matejsedik/maturitny_projekt-strelba-terce/03_Navrh/navod_tabulka_pinov.docx

# Návod: ako dopĺňať tabuľku pinov

Tento návod patrí k súboru tabulka_pinov.xlsx (rovnaký priečinok, 03_Navrh). Tabuľka je zatiaľ len kostra. Dopĺňa sa po tom, ako sa nakúpia presné súčiastky.

# Na čo tabuľka slúži

Odpovedá na otázku, ktorý drôt ide do ktorého pinu na ESP32. Pin je kovová nožička na doske ESP32, jeho číslo sa volá GPIO. Na jeden pin sa pripája jedna vec (senzor, servo, spínač…). Podľa tabuľky zapája Sára a podľa tej istej tabuľky píše firmvér Matej.

# Čo je v tabuľke

Tabuľka má dva hárky (záložky dole):

- Terčová jednotka – piny pre ESP32 v terči (senzory zásahu, servá, motor krycieho plátu, koncové spínače, batéria, LED).
- Napájanie a pravidlá – ako sa čo napája a ktoré piny sa nesmú používať. Pred výberom pinu si ho prečítať.

# Čo znamenajú stĺpce

Stĺpec | Čo tam patrí
Funkcia | na čo to je (napr. „Snímanie zásahu – ľah, terč 1“). Zvyčajne už vyplnené.
Súčiastka | presný názov súčiastky tak, ako sa nakúpila (napr. typ z e-shopu alebo z obalu). Kostra obsahuje len pôvodne plánovaný typ, po nákupe sa prepíše skutočným.
Signál | názov vývodu na súčiastke (napr. OUT, PWM, IN1). Zistí sa zo schémy vývodov súčiastky (pinout).
GPIO | číslo pinu na ESP32, na ktorý sa signál pripojí. Toto je hlavná vec, ktorú treba doplniť.
Smer | či pin signál číta (vstup), alebo ho posiela (výstup).
Stav | Nevyplnené (GPIO ešte nie je zvolené), Návrh (zvolené, ale nezapojené), Overené (funguje na stole), Zapojené (zapojené na doske). Vyberá sa zo zoznamu.
Poznámka | upozornenia k zapojeniu (napr. vonkajší odpor, napájanie).

# Ako dopĺňať po nákupe – krok za krokom

1. Zistiť presný typ súčiastky z balenia alebo z objednávky a prepísať ho do stĺpca Súčiastka.
2. Nájsť schému vývodov (pinout) danej súčiastky v popise obchodu alebo v datasheete. Skontrolovať, aký signál súčiastka vyvádza a aké napätie potrebuje (3,3 V alebo 5 V).
3. Vybrať GPIO podľa pravidiel z hárku Napájanie a pravidlá: nepoužívať GPIO6–11, pre vstupy sa vyhnúť pinom 0, 2, 5, 12, 15, piny 34–39 sú len vstupy a pre spínače potrebujú vonkajší odpor 10 kΩ, batériu merať na pinoch 32–39.
4. Zapísať číslo do stĺpca GPIO a upraviť Smer a Poznámku, ak sa líšia od kostry.
5. Skontrolovať duplicity: v hornej časti hárka (riadok 3) musí byť „OK – žiadny pin sa neopakuje“. Ak tam je POZOR, jeden pin je použitý dvakrát a treba ho zmeniť.
6. Nastaviť Stav na Návrh. Po odskúšaní na stole na Overené a po zapojení na doske na Zapojené.
7. Prepísať rovnaké čísla do kódu: súbor piny.h v priečinku 04_Implementacia/src/firmver-terc musí obsahovať tie isté čísla ako tabuľka.
8. Oznámiť druhému (Sára Matejovi a naopak), že sa niečo zmenilo.

# Čo ak sa niečo zmení

Keď sa zmení súčiastka alebo zapojenie, upraví sa riadok v tabuľke a rovnaké číslo v súbore piny.h. Ak treba pridať ďalšiu súčiastku, použije sa prvý prázdny riadok na konci hárka (kontrola duplicít ho zahŕňa). Ak je riadkov málo, vloží sa nový riadok medzi existujúce a vzorec sa roztiahne.

# Príklad vyplneného riadka

Toto je len ukážka, nie skutočné údaje:

Stĺpec | Ukážka
Funkcia | Snímanie zásahu – ľah, terč 1
Súčiastka | Hallov senzor A3144 (typ z objednávky)
Signál | OUT
GPIO | (číslo pinu, ktoré sa vyberie)
Smer | vstup (INPUT_PULLUP)
Stav | Návrh → Overené → Zapojené

# Kto za čo zodpovedá

- Sára vlastní tabuľku: podľa nej zapája a dopĺňa ju pri zmene zapojenia.
- Matej podľa nej píše firmvér a udržiava súbor piny.h.
- Obaja si hlásia zmeny a zapisujú dôležité zmeny postupu do dokumentacia_postup_prac.docx (priečinok 06_Dokumentacia).
