matejsedik/maturitny_projekt-strelba-terce/03_Navrh/navrhy_zapojenia/navrh_zapojenia_00_prehlad.pdf

# Prehľad návrhov zapojenia

Z čoho sa skladá elektronika terčovej jednotky, ako sa spája s mobilom a v ktorom súbore je ktoré zapojenie nakreslené.

## NÁVRH ZAPOJENIA

Strana 1/1: prehľad

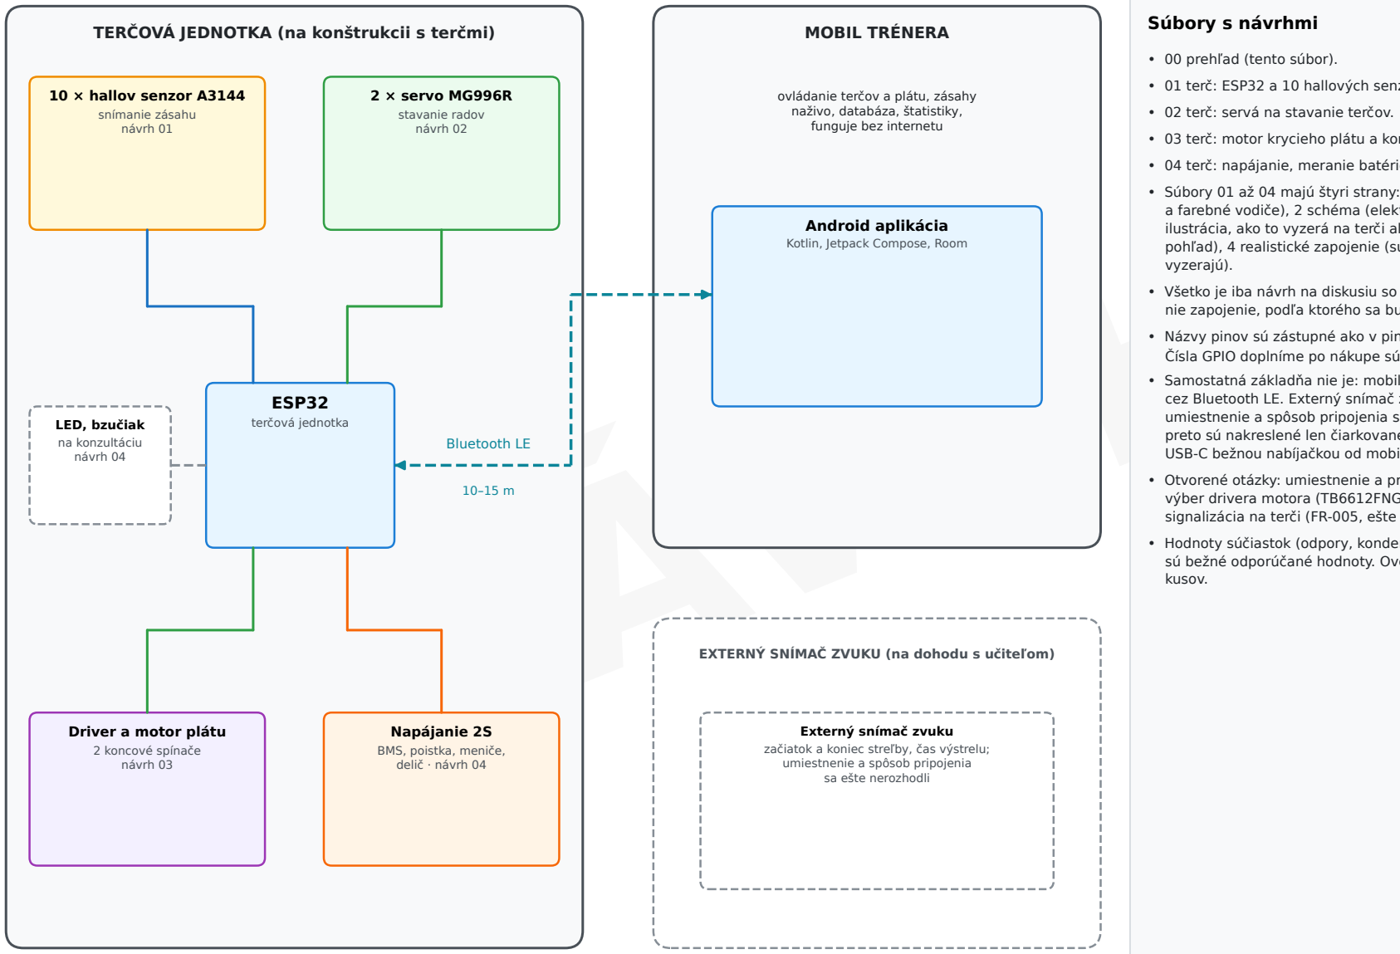
[picture p1: figure]
NÁVRH; Súbory s návrhmi; • 00 prehľad (tento súbor).; • 02 terč: servá na stavanie terčov.; vyzerajú).; kusov.; ESP32; terčová jednotka; 10 × hallov senzor A3144; snímanie zásahu návrh 01; 2 × servo MG996R stavanie radov návrh 02; Driver a motor plátu 2 koncové spínače návrh 03; Napájanie 2S BMS, poistka, meniče, delič · návrh 04; LED, bzučiak na konzultáciu návrh 04; MOBIL TRÉNERA; Android aplikácia Kotlin, Jetpack Compose, Room; ovládanie terčov a plátu, zásahy naživo, databáza, štatistiky, funguje bez internetu; Externý snímač zvuku; umiestnenie a spôsob pripojenia sa ešte nerozhodli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

- 01 terč: ESP32 a 10 hallových senzorov.
- 03 terč: motor krycieho plátu a koncové spínače.
- 04 terč: napájanie, meranie batérie, LED a bzučiak.
- Súbory 01 až 04 majú štyri strany: 1 blokový nákres (moduly a farebné vodiče), 2 schéma (elektrotechnické značky), 3 ilustrácia, ako to vyzerá na terči alebo v krabičke (3D pohľad), 4 realistické zapojenie (súčiastky tak, ako
- Všetko je iba návrh na diskusiu so Sárou a s Ing. Hollým, nie zapojenie, podľa ktorého sa bude stavať.
- Názvy pinov sú zástupné ako v piny.h a tabulka_pinov.xlsx. Čísla GPIO doplníme po nákupe súčiastok.
- Samostatná základňa nie je: mobil sa s terčom spája priamo cez Bluetooth LE. Externý snímač zvuku sa pridá, ale jeho umiestnenie a spôsob pripojenia sa ešte dohodnú s učiteľom, preto sú nakreslené len čiarkovane. Nabíjanie terča cez USB-C bežnou nabíjačkou od mobilu (modul 2S).
- Otvorené otázky: umiestnenie a pripojenie snímača zvuku, výber drivera motora (TB6612FNG alebo DRV8833), signalizácia na terči (FR-005, ešte sa konzultuje).
- Hodnoty súčiastok (odpory, kondenzátory, napätia meničov) sú bežné odporúčané hodnoty. Overiť v datasheetoch kúpených
Iba návrh na diskusiu, nie zapojenie, podľa ktorého sa bude stavať. Pred zapojením overiť s datasheetom konkrétnej súčiastky a s Ing. Hollým. | navrh_zapojenia_00_prehlad.pdf · návrh z 8. 11. 2026

### TERČOVÁ JEDNOTKA (na konštrukcii s terčmi)

EXTERNÝ SNÍMAČ ZVUKU (na dohodu s učiteľom)

začiatok a koniec streľby, čas výstrelu;
