matejsedik/maturitny_projekt-strelba-terce/03_Navrh/navrhy_zapojenia/navrh_zapojenia_01_terc_hallove_senzory.pdf

# Terčová jednotka: ESP32 a 10 hallových senzorov

## NÁVRH ZAPOJENIA

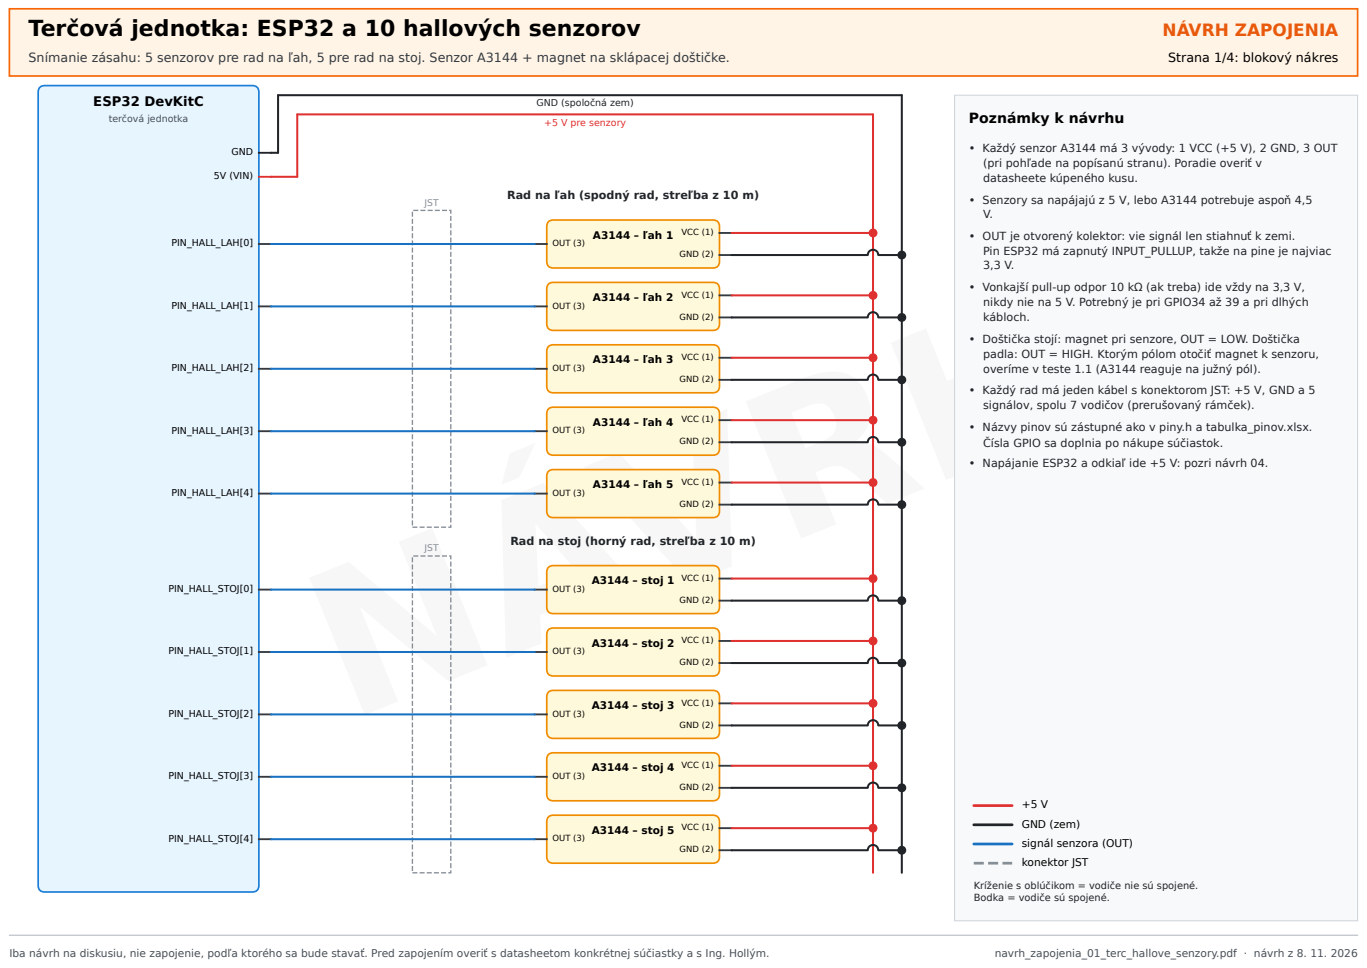
[picture p2: page 1]
NÁVRH; Poznámky k návrhu; Iba návrh na diskusiu, nie zapojenie, podľa ktorého sa bude stavať. Pred zapojením overiť s datasheetom konkrétnej súčiastky a s Ing. Hollým.; navrh_zapojenia_01_terc_hallove_senzory.pdf · návrh z 8. 11. 2026; ESP32 DevKitC; terčová jednotka; GND; 5V (VIN); PIN_HALL_LAH[0]; PIN_HALL_LAH[1]; PIN_HALL_LAH[2]; PIN_HALL_LAH[3]; PIN_HALL_LAH[4]; PIN_HALL_STOJ[0]; PIN_HALL_STOJ[1]; PIN_HALL_STOJ[2]; PIN_HALL_STOJ[3]; PIN_HALL_STOJ[4]; A3144 – ľah 1; OUT (3); VCC (1)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

Snímanie zásahu: 5 senzorov pre rad na ľah, 5 pre rad na stoj. Senzor A3144 + magnet na sklápacej doštičke.

Strana 1/4: blokový nákres

GND (spoločná zem)
+5 V pre senzory

• Každý senzor A3144 má 3 vývody: 1 VCC (+5 V), 2 GND, 3 OUT
(pri pohľade na popísanú stranu). Poradie overiť v
datasheete kúpeného kusu.
• Senzory sa napájajú z 5 V, lebo A3144 potrebuje aspoň 4,5
• OUT je otvorený kolektor: vie signál len stiahnuť k zemi.
Pin ESP32 má zapnutý INPUT_PULLUP, takže na pine je najviac
• Vonkajší pull-up odpor 10 kΩ (ak treba) ide vždy na 3,3 V,
nikdy nie na 5 V. Potrebný je pri GPIO34 až 39 a pri dlhých
kábloch.
• Doštička stojí: magnet pri senzore, OUT = LOW. Doštička
padla: OUT = HIGH. Ktorým pólom otočiť magnet k senzoru,
overíme v teste 1.1 (A3144 reaguje na južný pól).
• Každý rad má jeden kábel s konektorom JST: +5 V, GND a 5
signálov, spolu 7 vodičov (prerušovaný rámček).
• Názvy pinov sú zástupné ako v piny.h a tabulka_pinov.xlsx.
Čísla GPIO sa doplnia po nákupe súčiastok.
• Napájanie ESP32 a odkiaľ ide +5 V: pozri návrh 04.

Rad na ľah (spodný rad, streľba z 10 m)

Rad na stoj (horný rad, streľba z 10 m)

GND (zem)
signál senzora (OUT)
konektor JST

Kríženie s oblúčikom = vodiče nie sú spojené.
Bodka = vodiče sú spojené.

Strana 2/4: schéma

### Ako čítať schému

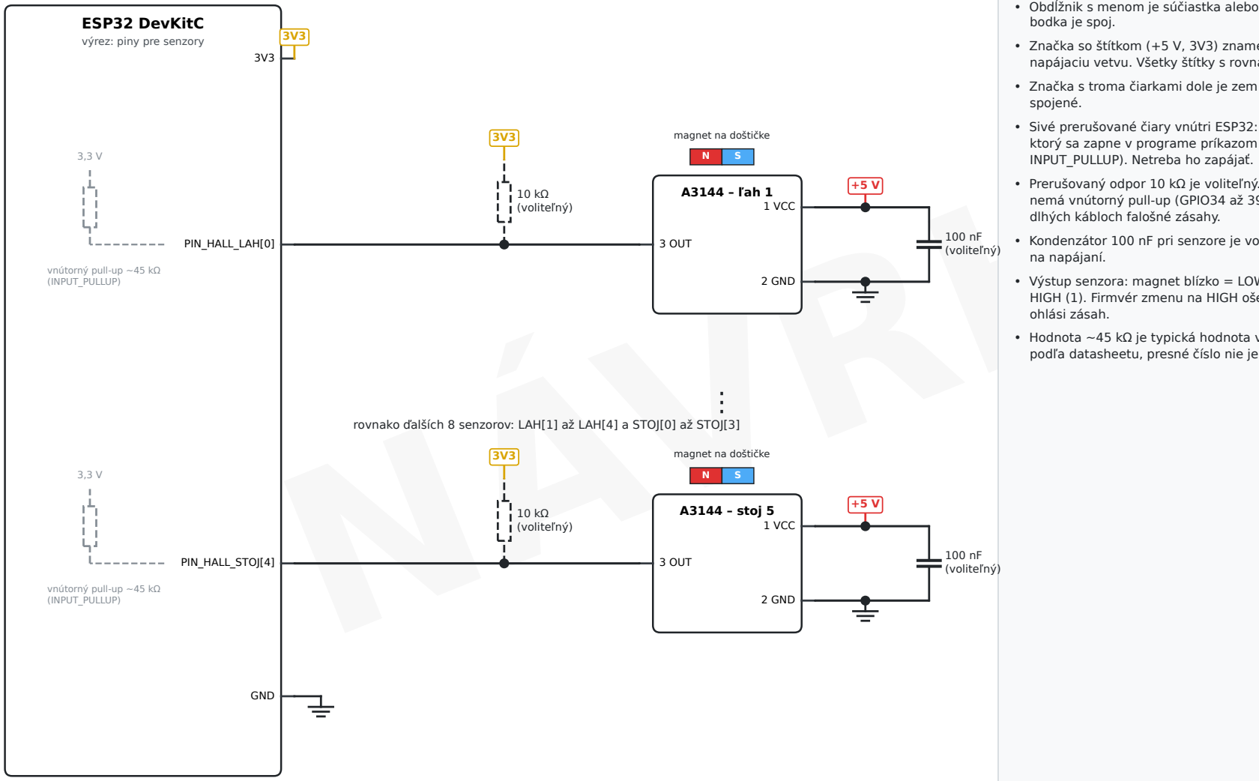
[picture p3: figure]
NÁVRH; bodka je spoj.; spojené.; INPUT_PULLUP). Netreba ho zapájať.; dlhých kábloch falošné zásahy.; na napájaní.; ohlási zásah.; ESP32 DevKitC; výrez: piny pre senzory; PIN_HALL_LAH[0]; PIN_HALL_STOJ[4]; GND; vnútorný pull-up ~45 kΩ (INPUT_PULLUP); A3144 – ľah 1; 3 OUT; 1 VCC; 2 GND; 10 kΩ (voliteľný); 100 nF (voliteľný); magnet na doštičke; A3144 – stoj 5

- Obdĺžnik s menom je súčiastka alebo modul, čiara je vodič,
- Značka so štítkom (+5 V, 3V3) znamená pripojenie na tú napájaciu vetvu. Všetky štítky s rovnakým menom sú spojené.
- Značka s troma čiarkami dole je zem (GND). Všetky zeme sú
- Sivé prerušované čiary vnútri ESP32: vnútorný pull-up,
ktorý sa zapne v programe príkazom pinMode(pin,
- Prerušovaný odpor 10 kΩ je voliteľný. Pridať ho, ak pin nemá vnútorný pull-up (GPIO34 až 39) alebo ak budú pri
- Kondenzátor 100 nF pri senzore je voliteľný, tlmí rušenie
- Výstup senzora: magnet blízko = LOW (0), magnet ďaleko = HIGH (1). Firmvér zmenu na HIGH ošetrí proti zákmitom a
- Hodnota ~45 kΩ je typická hodnota vnútorného pull-upu ESP32 podľa datasheetu, presné číslo nie je dôležité.

rovnako ďalších 8 senzorov: LAH[1] až LAH[4] a STOJ[0] až STOJ[3]

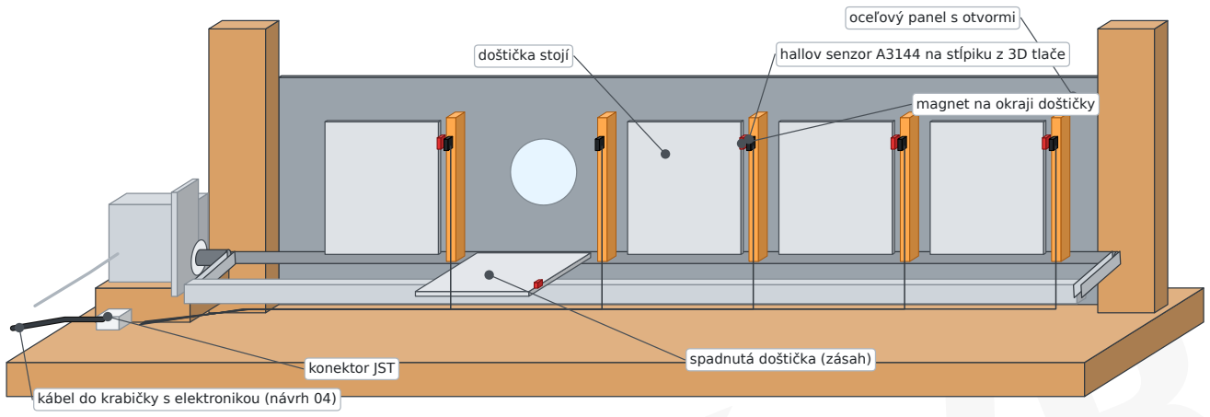
[picture p4: figure]
magnet na okraji doštičky; doštička stojí; spadnutá doštička (zásah) konektor JST; oceľový panel s otvormi

# NÁVRH

Strana 3/4: ako to vyzerá na terči (ilustrácia)

### Čo vidno na obrázku

- Je to zjednodušená ilustrácia, nie výkres. Rozmery a tvary sa budú upravovať pri 3D návrhu (Sára).
- Za každým otvorom stojí oceľová doštička na spoločnej osi. Zásah ju zhodí dozadu (k nám) na zdvíhaciu lištu.
- Na pravom okraji každej doštičky je nalepený malý magnet Ø 5 × 2 mm.
- Vedľa doštičky je stĺpik (3D tlač) a na ňom hallov senzor
vo výške magnetu. Senzor sa doštičky nedotýka, takže ho náraz strely nepoškodí.
- Stojaca doštička: magnet je pár milimetrov od senzora, výstup OUT je LOW. Spadnutá doštička: magnet sa vzdiali, OUT prejde na HIGH a ESP32 ohlási zásah.
- Od každého senzora idú 3 tenké vodiče dolu po stĺpiku a popri podstave ku konektoru JST. Jeden kábel na rad (7 vodičov).
- Rovnako vyzerá aj rad na ľah, len otvory majú Ø 15 mm a rad je nižšie.
- Vzdialenosť magnetu od senzora a ktorým pólom ho otočiť sa nájde v teste 1.1.

Terčový rad pri pohľade zozadu (strelec stojí za panelom)

Detail jednej doštičky

Doštička stojí: magnet je pri senzore → OUT = LOW (0) | Doštička spadla: magnet je ďaleko → OUT = HIGH (1)

hallov senzor A3144 na stĺpiku z 3D tlače

kábel do krabičky s elektronikou (návrh 04)

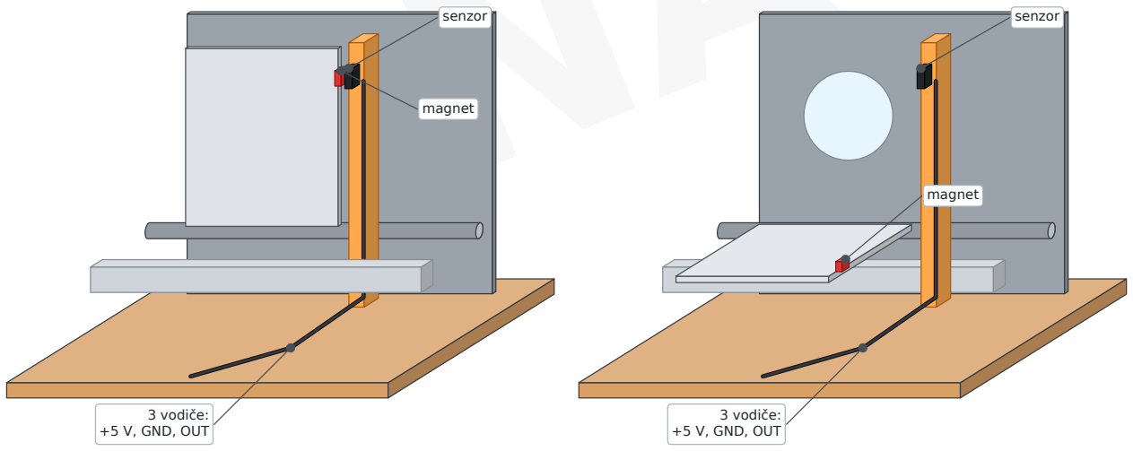
[picture p5: figure]
senzor; magnet; 3 vodiče: +5 V, GND, OUT

Strana 4/4: realistické zapojenie (ilustrácia)

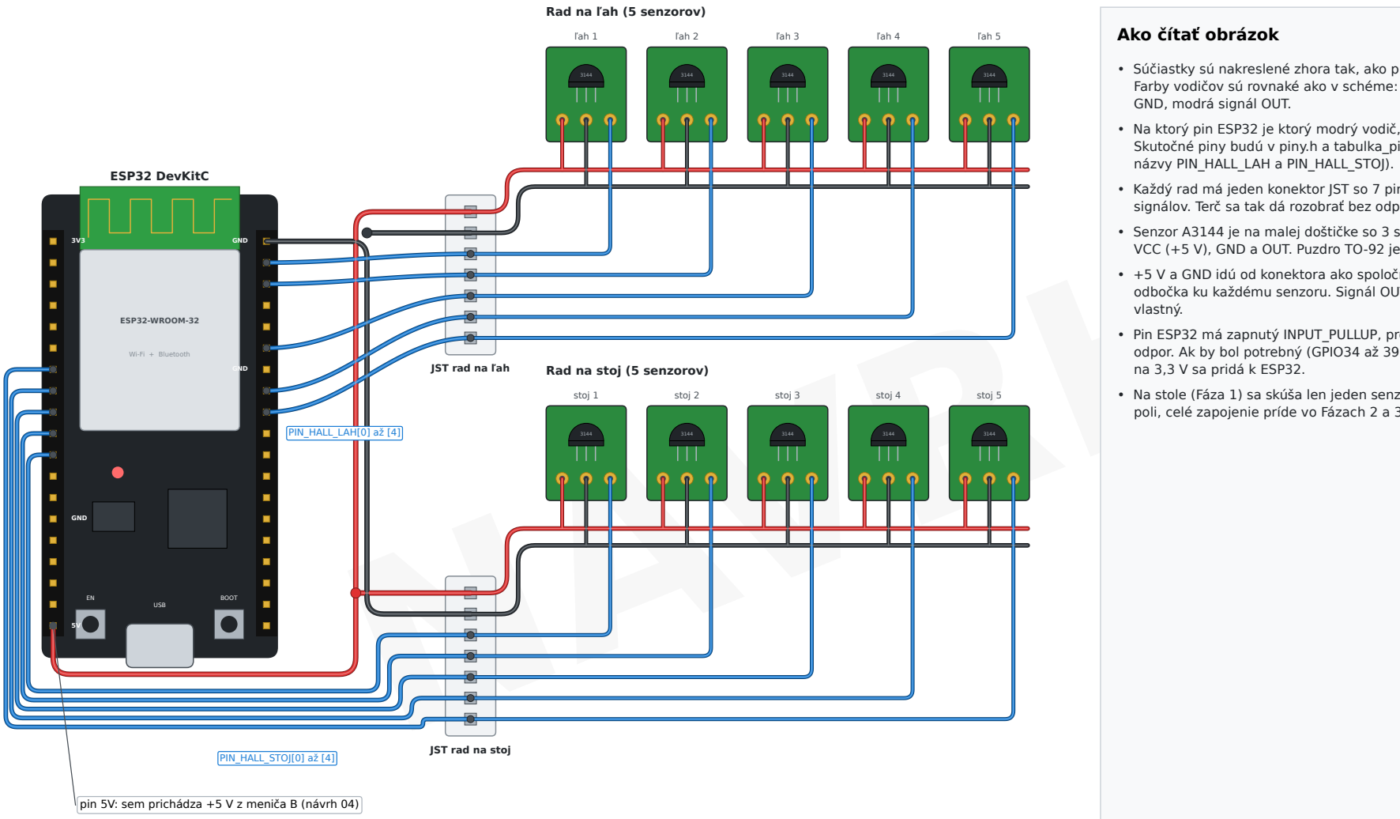
[picture p6: figure]
NÁVRH; Ako čítať obrázok; GND, modrá signál OUT.; názvy PIN_HALL_LAH a PIN_HALL_STOJ).; vlastný.; na 3,3 V sa pridá k ESP32.; ESP32-WROOM-32; Wi-Fi + Bluetooth; BOOT; USB; GND; ESP32 DevKitC; JST rad na ľah; JST rad na stoj; ľah 1; ľah 2; ľah 3; ľah 4; ľah 5; Rad na ľah (5 senzorov); stoj 1; stoj 2; stoj 3; stoj 4; stoj 5; Rad na stoj (5 senzorov); PIN_HALL_LAH[0] až [4]; PIN_HALL_STOJ[0] až [4]

- Súčiastky sú nakreslené zhora tak, ako približne vyzerajú. Farby vodičov sú rovnaké ako v schéme: červená +5 V, čierna
- Na ktorý pin ESP32 je ktorý modrý vodič, je len ilustrácia. Skutočné piny budú v piny.h a tabulka_pinov.xlsx (zástupné
- Každý rad má jeden konektor JST so 7 pinmi: +5 V, GND a 5 signálov. Terč sa tak dá rozobrať bez odpájkovania.
- Senzor A3144 je na malej doštičke so 3 spájkovacími bodmi: VCC (+5 V), GND a OUT. Puzdro TO-92 je otočené k magnetu.
- +5 V a GND idú od konektora ako spoločné vodiče a od nich odbočka ku každému senzoru. Signál OUT má každý senzor
- Pin ESP32 má zapnutý INPUT_PULLUP, preto na doštičke nie je odpor. Ak by bol potrebný (GPIO34 až 39, dlhé káble), 10 kΩ
- Na stole (Fáza 1) sa skúša len jeden senzor na nepájivom poli, celé zapojenie príde vo Fázach 2 a 3.

pin 5V: sem prichádza +5 V z meniča B (návrh 04)
