matejsedik/maturitny_projekt-strelba-terce/03_Navrh/navrhy_zapojenia/navrh_zapojenia_04_terc_napajanie_a_signalizacia.pdf

# Terčová jednotka: napájanie, meranie batérie a signalizácia

Batéria 2 × 18650 (2S) s ochranou, poistka, vypínač, dva meniče napätia, delič na meranie batérie, LED a bzučiak (na konzultáciu).

## NÁVRH ZAPOJENIA

Strana 1/4: blokový nákres

### Poznámky k návrhu

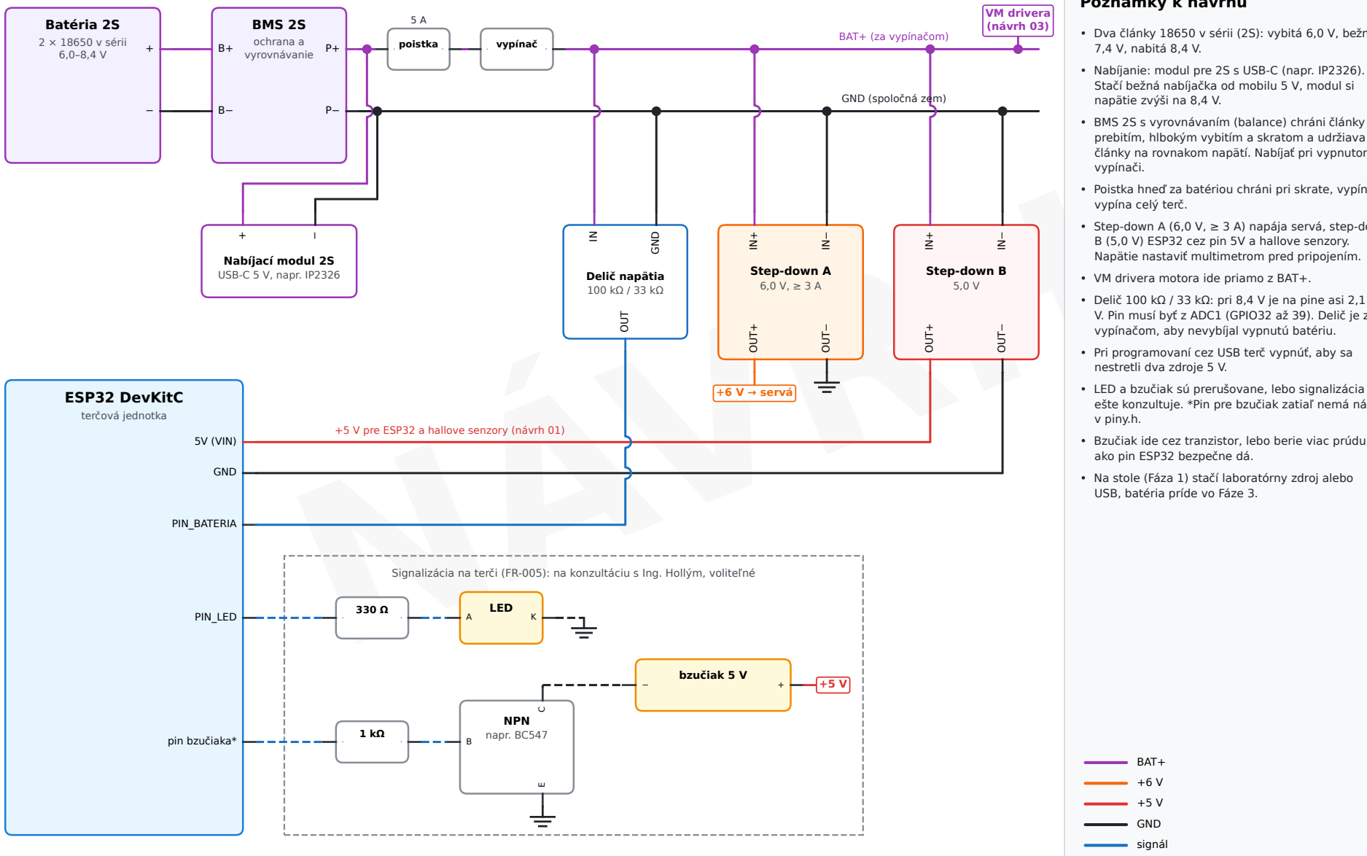
[picture p7: figure]
NÁVRH; 7,4 V, nabitá 8,4 V.; napätie zvýši na 8,4 V.; vypínači.; vypína celý terč.; Napätie nastaviť multimetrom pred pripojením.; • VM drivera motora ide priamo z BAT+.; vypínačom, aby nevybíjal vypnutú batériu.; nestretli dva zdroje 5 V.; v piny.h.; ako pin ESP32 bezpečne dá.; USB, batéria príde vo Fáze 3.; BAT+; GND; signál; Batéria 2S; 2 × 18650 v sérii; BMS 2S; ochrana a vyrovnávanie B+; poistka b; vypínač b; BAT+ (za vypínačom); GND (spoločná zem); VM drivera (návrh 03); Nabíjací modul 2S USB-C 5 V, napr. IP2326; Delič napätia; GND OUT; Step-down A 6,0 V, ≥ 3 A; IN+ IN− OUT+ OUT−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

- Dva články 18650 v sérii (2S): vybitá 6,0 V, bežne
- Nabíjanie: modul pre 2S s USB-C (napr. IP2326). Stačí bežná nabíjačka od mobilu 5 V, modul si
- BMS 2S s vyrovnávaním (balance) chráni články pred prebitím, hlbokým vybitím a skratom a udržiava oba články na rovnakom napätí. Nabíjať pri vypnutom
- Poistka hneď za batériou chráni pri skrate, vypínač
- Step-down A (6,0 V, ≥ 3 A) napája servá, step-down B (5,0 V) ESP32 cez pin 5V a hallove senzory.
- Delič 100 kΩ / 33 kΩ: pri 8,4 V je na pine asi 2,1
V. Pin musí byť z ADC1 (GPIO32 až 39). Delič je za
- Pri programovaní cez USB terč vypnúť, aby sa
- LED a bzučiak sú prerušovane, lebo signalizácia sa ešte konzultuje. *Pin pre bzučiak zatiaľ nemá názov
- Bzučiak ide cez tranzistor, lebo berie viac prúdu,
- Na stole (Fáza 1) stačí laboratórny zdroj alebo
Iba návrh na diskusiu, nie zapojenie, podľa ktorého sa bude stavať. Pred zapojením overiť s datasheetom konkrétnej súčiastky a s Ing. Hollým. | navrh_zapojenia_04_terc_napajanie_a_signalizacia.pdf · návrh z 8. 11. 2026

+5 V pre ESP32 a hallove senzory (návrh 01)

Signalizácia na terči (FR-005): na konzultáciu s Ing. Hollým, voliteľné

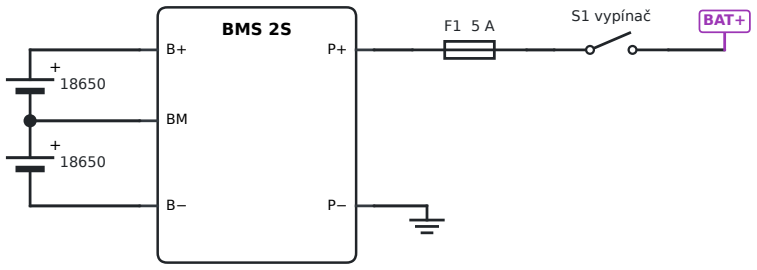
[picture p8: figure]
BMS 2S; S1 vypínač; BAT+

# NÁVRH

Strana 2/4: schéma

### Ako čítať schému

- Dva články v sérii: + horného článku je + batérie, − dolného je −. Stred (BM) ide do BMS, aby vedel strážiť každý článok.
- F1 je poistka, S1 hlavný vypínač. Za nimi je vetva BAT+. Rovnaký štítok = rovnaké prepojenie.
- Delič: U_pin = U_bat × 33 / (100 + 33). Pri 8,4 V asi 2,1 V, pri 6,0 V asi 1,5 V. Kondenzátor 100 nF upokojí meranie.
- Firmvér prepočíta späť: U_bat = U_pin × 133 / 33.
ADC na ESP32 nie je veľmi presný, meranie porovnáme s multimetrom.
- LED: odpor 330 Ω obmedzí prúd na približne 4 mA.
- Bzučiak: tranzistor NPN spína bzučiak z +5 V, odpor
1 kΩ do bázy chráni pin. Typ bzučiaka (aktívny/pasívny) sa vyberie po konzultácii.
- *Pin pre bzučiak zatiaľ nemá názov v piny.h ani číslo v tabuľke pinov.

nabíjací modul 2S (USB-C) sa pripája na P+ a P−

BAT+

R1 100 kΩ

R2 33 kΩ

100 nF

BAT_ADC

Step-down A
IN+ | 6,0 V, ≥ 3 A

IN−

OUT+

OUT−

BAT+

+6 V | Step-down B
IN+ | 5,0 V

IN−

OUT+

OUT−

BAT+

+5 V

VM drivera motora
je priamo na BAT+
(návrh 03)

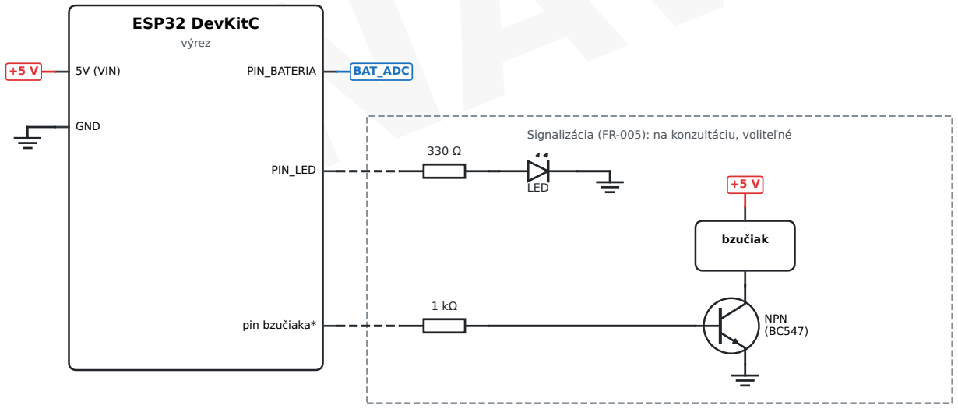
[picture p9: figure]
ESP32 DevKitC; výrez; 5V (VIN); GND; PIN_BATERIA; PIN_LED; pin bzučiaka*; BAT_ADC; Signalizácia (FR-005): na konzultáciu, voliteľné; LED; NPN (BC547); bzučiak

# NÁVRH

Strana 3/4: ako to vyzerá v krabičke (ilustrácia)

### Čo vidno na obrázku

- Zjednodušená ilustrácia, nie výkres. Rozmery krabičky (tu asi 23 × 15 × 8 cm) a rozmiestnenie sa určia pri 3D návrhu.
- Krabička je z 3D tlače (PETG), stojí na gumených tlmičoch a je schovaná za oceľovým štítom, aby ju nezasiahla strela ani neotriasala.
- Vzadu je batéria 2S v držiaku a vedľa nej BMS a poistka. Vpredu je ESP32 na dierkovanej doske, napravo dva meniče napätia.
- ESP32 sa s mobilom spája cez Bluetooth. Oceľový štít rádio tlmí, preto anténa ESP32 (koniec dosky) nesmie byť celá za štítom, alebo sa použije ESP32 s externou anténou.
- Všetky káble von idú cez konektory JST na zadnej stene, takže sa krabička dá odpojiť a vybrať.
- Hlavný vypínač a otvor USB-C na nabíjanie sú dostupné zvonku. Nabíja sa pri vypnutom terči.
- Signalizácia (LED, bzučiak) tu nie je nakreslená, lebo sa ešte konzultuje s Ing. Hollým.
- Vodiče sú nakreslené len naznačene. Presné zapojenie je na stranách 1, 2 a 4.

Krabička s elektronikou terča bez veka (predná a pravá stena sú priehľadné)

batéria 2 × 18650
v držiaku

BMS 2S

poistka 5 A

hlavný vypínač
(vyvedený von)

menič A: 6,0 V
pre servá

menič B: 5,0 V
pre ESP32 a senzory

nabíjací modul 2S

otvor USB-C
na nabíjanie

ESP32 na dierkovanej doske

delič napätia
100 kΩ / 33 kΩ

konektory JST: senzory, servá, motor, spínače

gumené tlmiče

Strana 4/4: realistické zapojenie (ilustrácia)

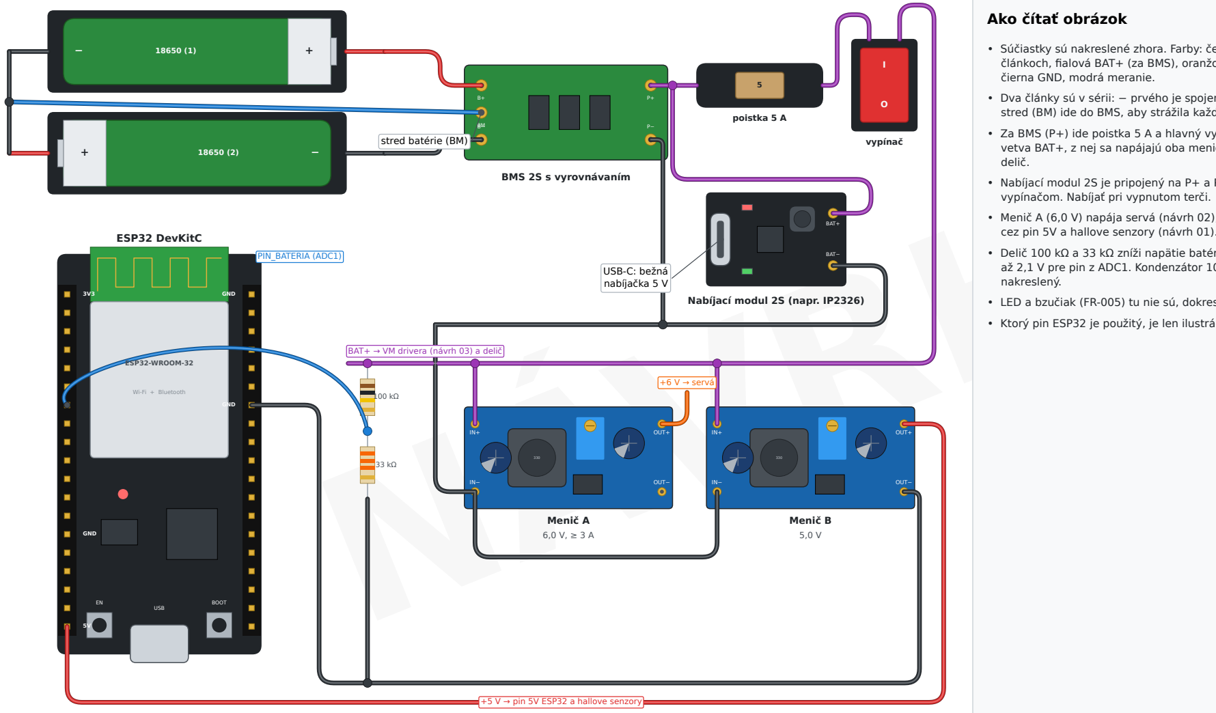
[picture p10: figure]
NÁVRH; Ako čítať obrázok; čierna GND, modrá meranie.; delič.; vypínačom. Nabíjať pri vypnutom terči.; nakreslený.; ESP32-WROOM-32; Wi-Fi + Bluetooth; BOOT; USB; GND; ESP32 DevKitC; BMB−; BMS 2S s vyrovnávaním; poistka 5 A; vypínač; BAT+; BAT−; Nabíjací modul 2S (napr. IP2326); OUT+; OUT−; Menič A 6,0 V, ≥ 3 A; Menič B 5,0 V; +6 V → servá; +5 V → pin 5V ESP32 a hallove senzory; BAT+ → VM drivera (návrh 03) a delič; PIN_BATERIA (ADC1); stred batérie (BM); USB-C: bežná nabíjačka 5 V

- Súčiastky sú nakreslené zhora. Farby: červená a čierna pri článkoch, fialová BAT+ (za BMS), oranžová +6 V, červená +5 V,
- Dva články sú v sérii: − prvého je spojený s + druhého. Tento stred (BM) ide do BMS, aby strážila každý článok zvlášť.
- Za BMS (P+) ide poistka 5 A a hlavný vypínač. Za vypínačom je vetva BAT+, z nej sa napájajú oba meniče, driver motora a
- Nabíjací modul 2S je pripojený na P+ a P−, teda pred
- Menič A (6,0 V) napája servá (návrh 02), menič B (5,0 V) ESP32 cez pin 5V a hallove senzory (návrh 01).
- Delič 100 kΩ a 33 kΩ zníži napätie batérie na bezpečných 1,5 až 2,1 V pre pin z ADC1. Kondenzátor 100 nF na pine tu nie je
- LED a bzučiak (FR-005) tu nie sú, dokreslia sa po konzultácii.
- Ktorý pin ESP32 je použitý, je len ilustrácia.
