matejsedik/maturitny_projekt-strelba-terce/03_Navrh/navrhy_zapojenia/navrh_zapojenia_02_terc_serva.pdf

# Terčová jednotka: servá na stavanie terčov

Dve servá MG996R (rad na ľah a rad na stoj) s vlastným meničom napätia a spoločnou zemou s ESP32.

## NÁVRH ZAPOJENIA

Strana 1/4: blokový nákres

### Poznámky k návrhu

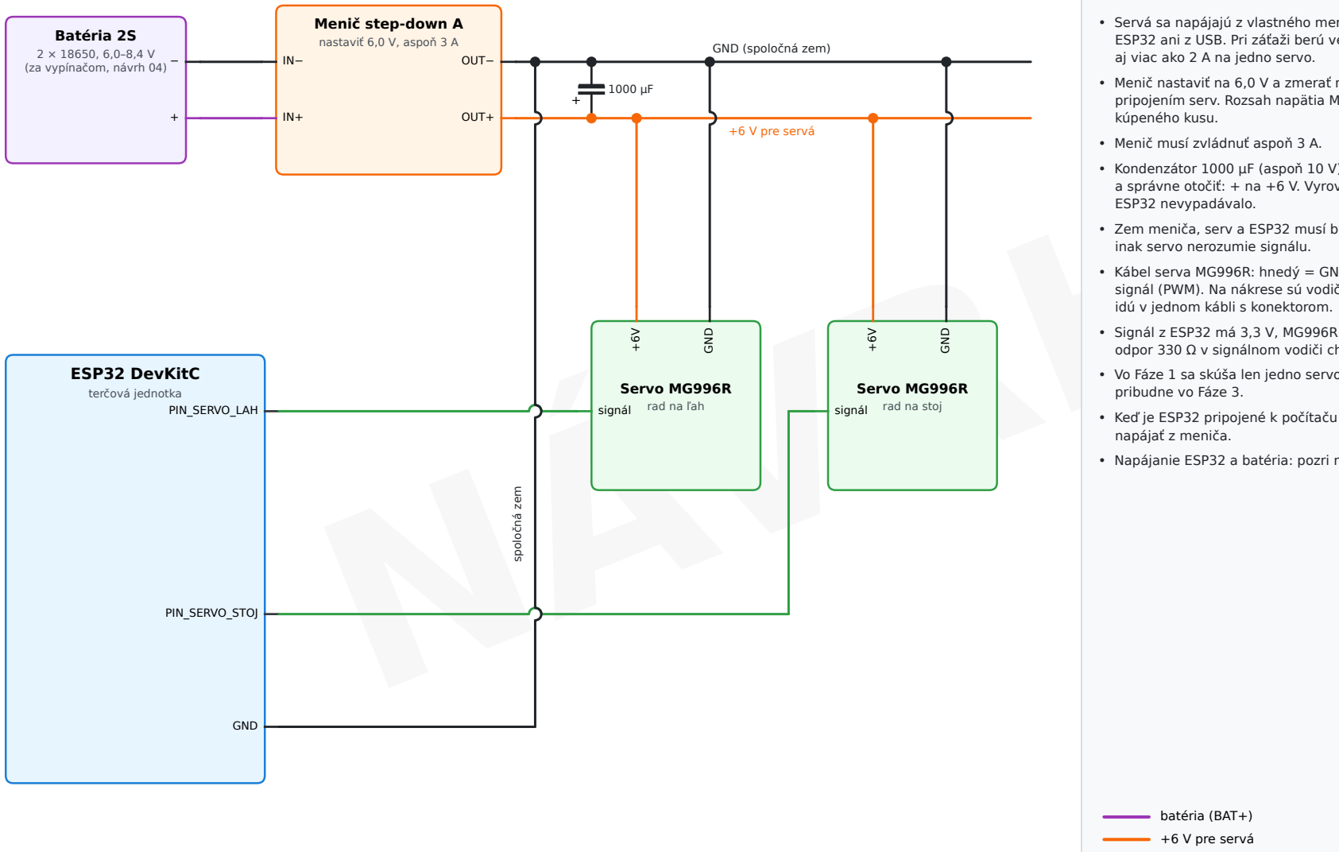
[picture p11: figure]
NÁVRH; aj viac ako 2 A na jedno servo.; kúpeného kusu.; • Menič musí zvládnuť aspoň 3 A.; ESP32 nevypadávalo.; inak servo nerozumie signálu.; idú v jednom kábli s konektorom.; pribudne vo Fáze 3.; napájať z meniča.; batéria (BAT+); +6 V pre servá; Batéria 2S; 2 × 18650, 6,0–8,4 V (za vypínačom, návrh 04) −; Menič step-down A; nastaviť 6,0 V, aspoň 3 A; OUT−; OUT+; GND (spoločná zem); ESP32 DevKitC; terčová jednotka PIN_SERVO_LAH; PIN_SERVO_STOJ; GND; Servo MG996R rad na ľah; signál; Servo MG996R rad na stoj; spoločná zem

- Servá sa napájajú z vlastného meniča (step-down A), nie z ESP32 ani z USB. Pri záťaži berú veľký prúd, pri zaseknutí
- Menič nastaviť na 6,0 V a zmerať multimetrom ešte pred pripojením serv. Rozsah napätia MG996R overiť v datasheete
- Kondenzátor 1000 µF (aspoň 10 V) dať čo najbližšie k servám a správne otočiť: + na +6 V. Vyrovnáva prúdové nárazy, aby
- Zem meniča, serv a ESP32 musí byť spojená (spoločná zem),
- Kábel serva MG996R: hnedý = GND, červený = +6 V, oranžový = signál (PWM). Na nákrese sú vodiče rozdelené, v skutočnosti
- Signál z ESP32 má 3,3 V, MG996R ho bežne zvládne. Voliteľný odpor 330 Ω v signálnom vodiči chráni pin (pozri schému).
- Vo Fáze 1 sa skúša len jedno servo (rad na ľah), druhé
- Keď je ESP32 pripojené k počítaču cez USB, servá aj tak
- Napájanie ESP32 a batéria: pozri návrh 04.
Iba návrh na diskusiu, nie zapojenie, podľa ktorého sa bude stavať. Pred zapojením overiť s datasheetom konkrétnej súčiastky a s Ing. Hollým. | navrh_zapojenia_02_terc_serva.pdf · návrh z 8. 11. 2026 GND (zem) signál PWM
| Kríženie s oblúčikom = vodiče nie sú spojené.

Strana 2/4: schéma

### Ako čítať schému

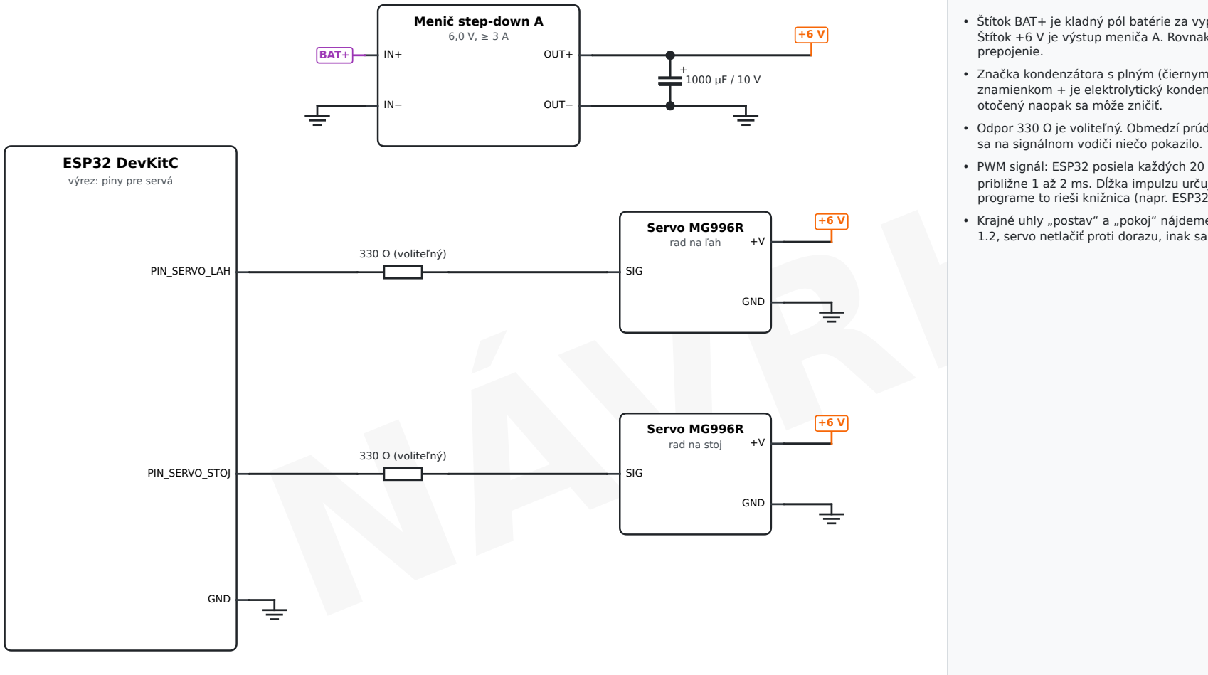
[picture p12: figure]
NÁVRH; prepojenie.; otočený naopak sa môže zničiť.; sa na signálnom vodiči niečo pokazilo.; Menič step-down A 6,0 V, ≥ 3 A; OUT+; OUT−; BAT+; ESP32 DevKitC; výrez: piny pre servá; PIN_SERVO_LAH; PIN_SERVO_STOJ; GND; Servo MG996R rad na ľah; SIG; 330 Ω (voliteľný); Servo MG996R rad na stoj

- Štítok BAT+ je kladný pól batérie za vypínačom (návrh 04). Štítok +6 V je výstup meniča A. Rovnaký štítok = rovnaké
- Značka kondenzátora s plným (čiernym) taniérikom a znamienkom + je elektrolytický kondenzátor. Má polaritu,
- Odpor 330 Ω je voliteľný. Obmedzí prúd do pinu ESP32, keby
- PWM signál: ESP32 posiela každých 20 ms impulz dlhý približne 1 až 2 ms. Dĺžka impulzu určuje uhol serva. V programe to rieši knižnica (napr. ESP32Servo).
- Krajné uhly „postav“ a „pokoj“ nájdeme skúšaním v teste 1.2, servo netlačiť proti dorazu, inak sa prehrieva.

Všetky značky zeme sú navzájom spojené (spoločná zem meniča, serv a ESP32).

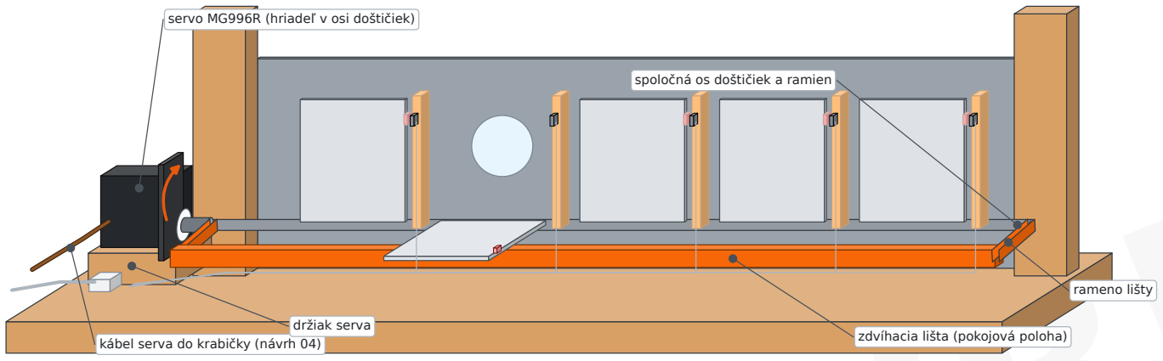
[picture p13: figure]
servo MG996R (hriadeľ v osi doštičiek); zdvíhacia lišta (pokojová poloha); rameno lišty; spoločná os doštičiek a ramien; kábel serva do krabičky (návrh 04); držiak serva

# NÁVRH

Strana 3/4: ako to vyzerá na terči (ilustrácia)

### Čo vidno na obrázku

- Je to zjednodušená ilustrácia, nie výkres. Tvar lišty, ramien a držiaka serva sa upraví pri 3D návrhu (Sára).
- Každý rad má jedno servo na kraji radu. Hriadeľ serva je v rovnakej osi, okolo ktorej sa sklápajú doštičky.
- Servo otáča dvoma ramenami a medzi nimi je zdvíhacia lišta. V pokojovej polohe je lišta dole, spadnuté doštičky na nej ležia.
- Pri príkaze „postav“ servo otočí lištu hore, tá zdvihne
všetky spadnuté doštičky naraz, potom sa vráti dole. Stojace doštičky lišta nepotláča.
- Lišta sa musí vrátiť úplne dole, aby nebránila ďalšiemu zásahu.
- Po postavení ESP32 prečíta hallove senzory. Ak niektorá doštička nestojí, appka ukáže chybu.
- Servo je za štítom a mimo dráhy striel. Kábel serva ide do krabičky s elektronikou.
- Uhly „pokoj“ a „postav“ sa nájdu skúšaním v teste 1.2.

Terčový rad pri pohľade zozadu: servo a zdvíhacia lišta

Ako servo postaví spadnuté doštičky (pohľad zboku)

### 1. Doštička spadla a leží na lište

### 2. Servo otočí lištu hore

### 3. Lišta sa vráti, doštička stojí

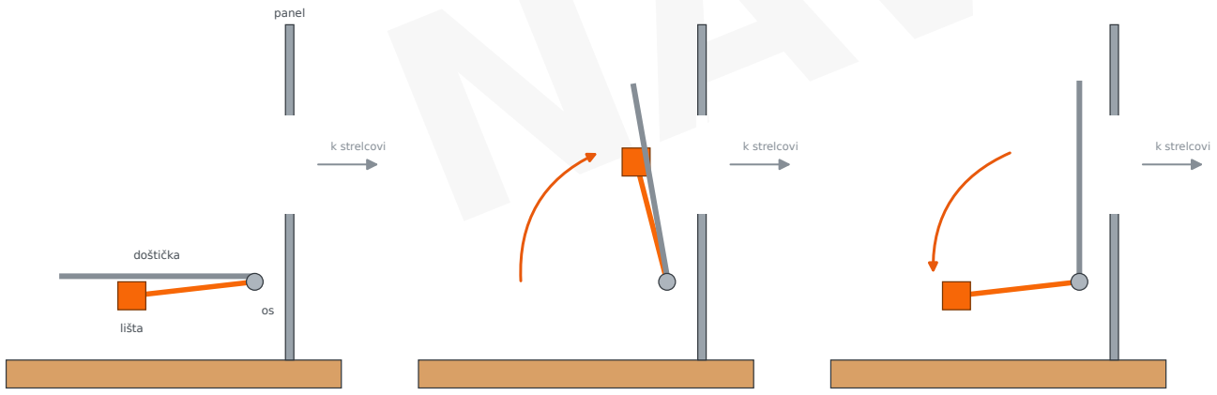
[picture p14: figure]
lišta; doštička; panel; k strelcovi

Strana 4/4: realistické zapojenie (ilustrácia)

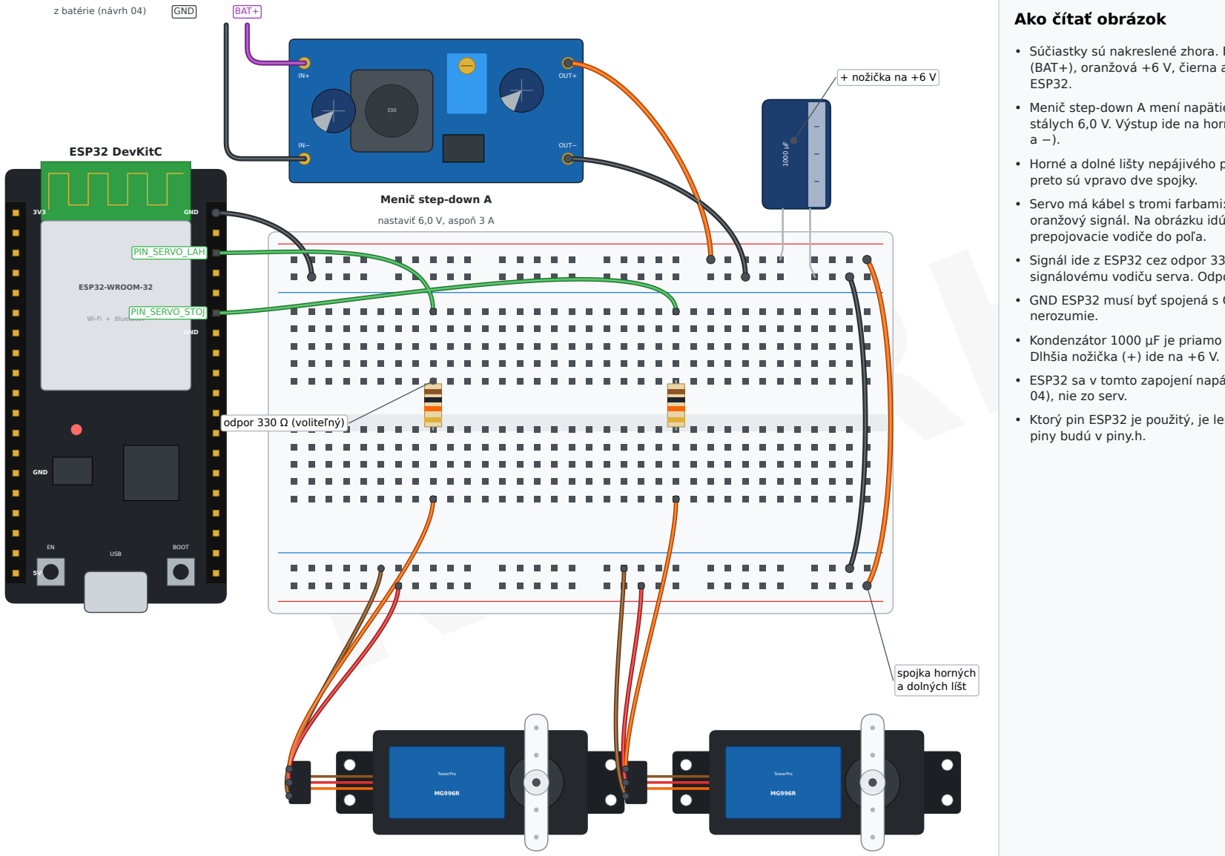
[picture p15: figure]
NÁVRH; Ako čítať obrázok; ESP32.; preto sú vpravo dve spojky.; prepojovacie vodiče do poľa.; nerozumie.; Dlhšia nožička (+) ide na +6 V.; 04), nie zo serv.; piny budú v piny.h.; ESP32-WROOM-32; Wi-Fi + Bluetooth; BOOT; USB; GND; ESP32 DevKitC; OUT+; OUT−; Menič step-down A; nastaviť 6,0 V, aspoň 3 A; z batérie (návrh 04); TowerPro; BAT+; PIN_SERVO_LAH; PIN_SERVO_STOJ; odpor 330 Ω (voliteľný); + nožička na +6 V; spojka horných a dolných líšt

- Súčiastky sú nakreslené zhora. Farby: fialová batéria (BAT+), oranžová +6 V, čierna a hnedá GND, zelená signál z
- Menič step-down A mení napätie batérie (6,0–8,4 V) na stálych 6,0 V. Výstup ide na horné lišty nepájivého poľa (+
- Horné a dolné lišty nepájivého poľa nie sú vnútri spojené,
- Servo má kábel s tromi farbami: hnedý GND, červený +6 V, oranžový signál. Na obrázku idú z konektora tri
- Signál ide z ESP32 cez odpor 330 Ω (voliteľný) k
signálovému vodiču serva. Odpor premosťuje stred poľa.
- GND ESP32 musí byť spojená s GND meniča, inak servo signálu
- Kondenzátor 1000 µF je priamo na lištách pri servách.
- ESP32 sa v tomto zapojení napája zvlášť (z meniča B, návrh
- Ktorý pin ESP32 je použitý, je len ilustrácia. Skutočné

Servo MG996R – rad na ľah

Servo MG996R – rad na stoj
