matejsedik/maturitny_projekt-strelba-terce/03_Navrh/navrhy_zapojenia/navrh_zapojenia_03_terc_kryci_plat.pdf

# Terčová jednotka: motor krycieho plátu a koncové spínače

Motorček s prevodovkou (navijak) cez driver motora TB6612FNG (alebo DRV8833), horný a dolný koncový spínač.

## NÁVRH ZAPOJENIA

Strana 1/4: blokový nákres

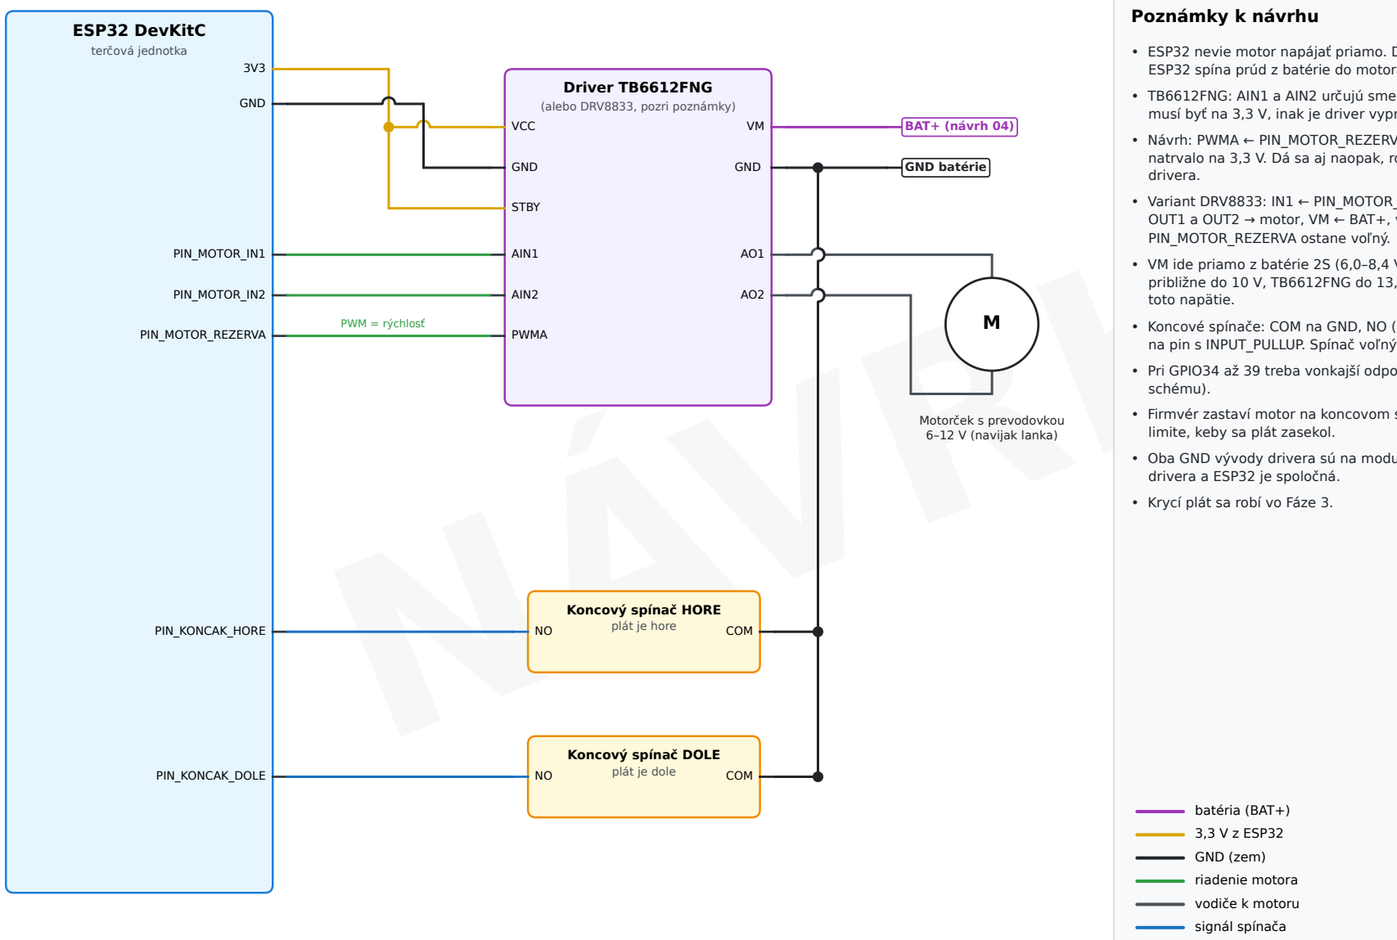
[picture p16: figure]
NÁVRH; Poznámky k návrhu; drivera.; PIN_MOTOR_REZERVA ostane voľný.; toto napätie.; schému).; limite, keby sa plát zasekol.; drivera a ESP32 je spoločná.; • Krycí plát sa robí vo Fáze 3.; batéria (BAT+) 3,3 V z ESP32; GND (zem); riadenie motora; vodiče k motoru; signál spínača; ESP32 DevKitC; terčová jednotka; GND; PIN_MOTOR_IN1; PIN_MOTOR_IN2; PIN_MOTOR_REZERVA; PIN_KONCAK_HORE; PIN_KONCAK_DOLE; Driver TB6612FNG; (alebo DRV8833, pozri poznámky); VCC; STBY; AIN1; AIN2; PWMA; PWM = rýchlosť; BAT+ (návrh 04); GND batérie; Motorček s prevodovkou 6–12 V (navijak lanka); Koncový spínač HORE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

- ESP32 nevie motor napájať priamo. Driver podľa signálov z ESP32 spína prúd z batérie do motora a mení smer otáčania.
- TB6612FNG: AIN1 a AIN2 určujú smer, PWMA rýchlosť. STBY musí byť na 3,3 V, inak je driver vypnutý.
- Návrh: PWMA ← PIN_MOTOR_REZERVA (rýchlosť cez PWM) a STBY natrvalo na 3,3 V. Dá sa aj naopak, rozhodneme pri výbere
- Variant DRV8833: IN1 ← PIN_MOTOR_IN1, IN2 ← PIN_MOTOR_IN2, OUT1 a OUT2 → motor, VM ← BAT+, vstup SLEEP (EEP) na 3,3 V.
- VM ide priamo z batérie 2S (6,0–8,4 V). DRV8833 zvláda približne do 10 V, TB6612FNG do 13,5 V. Motor vybrať na
- Koncové spínače: COM na GND, NO (normálne otvorený kontakt) na pin s INPUT_PULLUP. Spínač voľný = HIGH, stlačený = LOW.
- Pri GPIO34 až 39 treba vonkajší odpor 10 kΩ na 3,3 V (pozri
- Firmvér zastaví motor na koncovom spínači alebo po časovom
- Oba GND vývody drivera sú na module spojené. Zem batérie,
Iba návrh na diskusiu, nie zapojenie, podľa ktorého sa bude stavať. Pred zapojením overiť s datasheetom konkrétnej súčiastky a s Ing. Hollým. | navrh_zapojenia_03_terc_kryci_plat.pdf · návrh z 8. 11. 2026 Kríženie s oblúčikom = vodiče nie sú spojené.

Strana 2/4: schéma

### Ako čítať schému

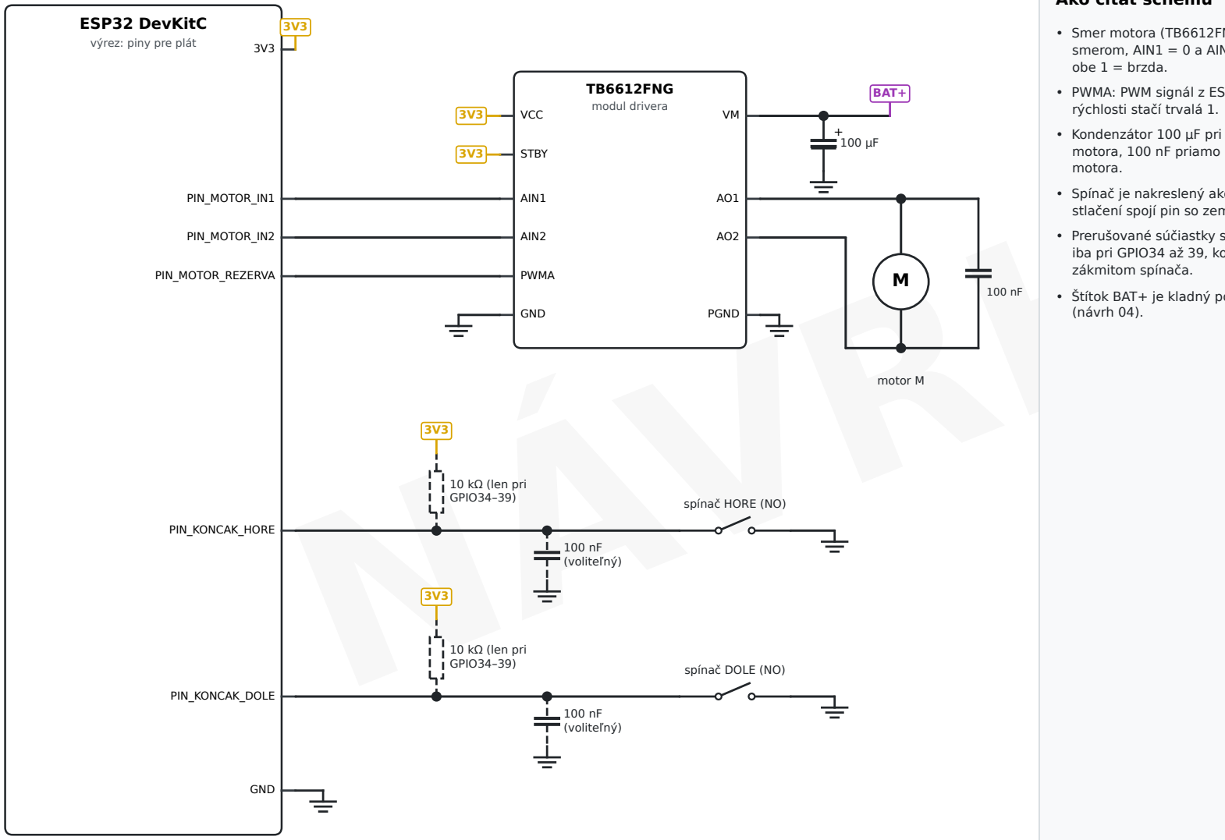
[picture p17: figure]
NÁVRH; obe 1 = brzda.; rýchlosti stačí trvalá 1.; motora.; zákmitom spínača.; (návrh 04).; ESP32 DevKitC; výrez: piny pre plát; PIN_MOTOR_IN1; PIN_MOTOR_IN2; PIN_MOTOR_REZERVA; PIN_KONCAK_HORE; PIN_KONCAK_DOLE; GND; TB6612FNG modul drivera; VCC; STBY; AIN1; AIN2; PWMA; PGND; BAT+; motor M; 10 kΩ (len pri GPIO34–39); 100 nF (voliteľný); spínač HORE (NO); spínač DOLE (NO)

- Smer motora (TB6612FNG): AIN1 = 1 a AIN2 = 0 točí jedným smerom, AIN1 = 0 a AIN2 = 1 druhým, obe 0 = motor stojí,
- PWMA: PWM signál z ESP32 určuje rýchlosť. Pri plnej
- Kondenzátor 100 µF pri VM vyrovnáva napätie pri rozbehu motora, 100 nF priamo na svorkách motora tlmí rušenie od
- Spínač je nakreslený ako rozpojený kontakt (NO). Pri stlačení spojí pin so zemou a pin prejde z HIGH na LOW.
- Prerušované súčiastky sú voliteľné. Odpor 10 kΩ je nutný iba pri GPIO34 až 39, kondenzátor 100 nF pomáha proti
- Štítok BAT+ je kladný pól batérie za poistkou a vypínačom

### Čo vidno na obrázku

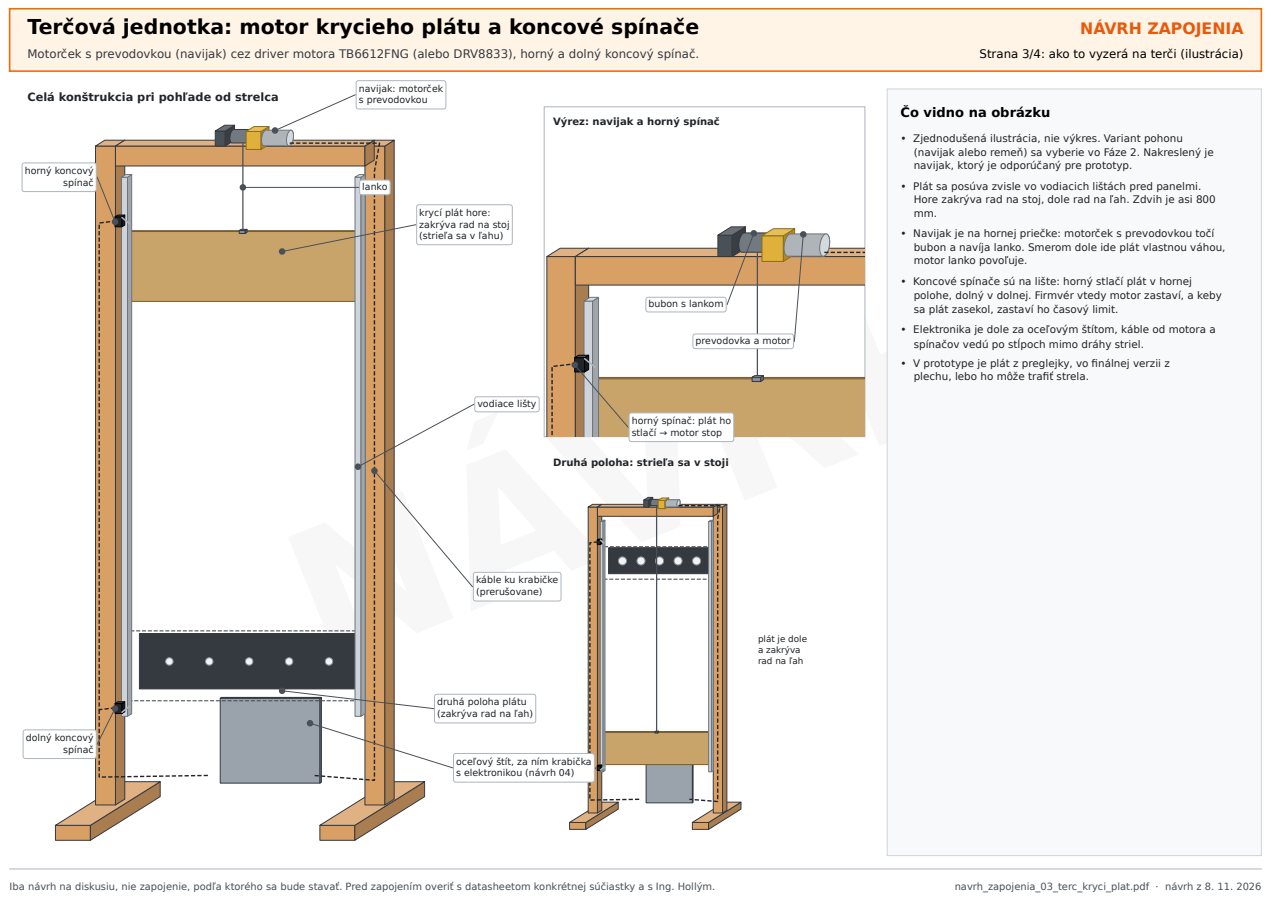
[picture p18: page 3]
NÁVRH; vodiace lišty; horný koncový spínač; dolný koncový spínač; navijak: motorček s prevodovkou; lanko; bubon s lankom; prevodovka a motor

Strana 3/4: ako to vyzerá na terči (ilustrácia)

Celá konštrukcia pri pohľade od strelca

Výrez: navijak a horný spínač

• Zjednodušená ilustrácia, nie výkres. Variant pohonu
(navijak alebo remeň) sa vyberie vo Fáze 2. Nakreslený je
navijak, ktorý je odporúčaný pre prototyp.
• Plát sa posúva zvisle vo vodiacich lištách pred panelmi.
Hore zakrýva rad na stoj, dole rad na ľah. Zdvih je asi 800
• Navijak je na hornej priečke: motorček s prevodovkou točí
bubon a navíja lanko. Smerom dole ide plát vlastnou váhou,
motor lanko povoľuje.
• Koncové spínače sú na lište: horný stlačí plát v hornej
polohe, dolný v dolnej. Firmvér vtedy motor zastaví, a keby
sa plát zasekol, zastaví ho časový limit.
• Elektronika je dole za oceľovým štítom, káble od motora a
spínačov vedú po stĺpoch mimo dráhy striel.
• V prototype je plát z preglejky, vo finálnej verzii z
plechu, lebo ho môže trafiť strela.

krycí plát hore:
zakrýva rad na stoj
(strieľa sa v ľahu)

horný spínač: plát ho stlačí → motor stop

Druhá poloha: strieľa sa v stoji

káble ku krabičke
(prerušovane)

plát je dole
a zakrýva
rad na ľah

druhá poloha plátu
(zakrýva rad na ľah)

oceľový štít, za ním krabička
s elektronikou (návrh 04)

# NÁVRH

Strana 4/4: realistické zapojenie (ilustrácia)

### Ako čítať obrázok

- Súčiastky sú nakreslené zhora. Farby: žltá 3,3 V, čierna
GND, zelená riadenie motora, fialová batéria, sivé vodiče
idú k motoru, modrá signál spínačov.
- Driver TB6612FNG je malá doska so 16 vývodmi. Logika (VCC, STBY) ide z 3,3 V ESP32, motor (VM) priamo z batérie terča.
- AIN1 a AIN2 určujú smer, PWMA rýchlosť. Výstupy AO1 a AO2 idú na dva vývody motora.
- Kondenzátor 100 µF je pri vstupe VM, 100 nF priamo na svorkách motora (tlmí rušenie).
- Mikrospínač má 3 vývody: C (spoločný), NO (normálne otvorený), NC (normálne zatvorený). Použije sa C na GND a NO na pin ESP32 s INPUT_PULLUP.
- Pri drivere DRV8833 je zapojenie podobné, len sa líšia názvy vývodov (pozri stranu 1).
- Ktoré piny ESP32 sú použité, je len ilustrácia. Skutočné piny budú v piny.h.

ESP32-WROOM-32

Wi-Fi + Bluetooth

EN | BOOT
USB

3V3

GND

5V

GND

GND

ESP32 DevKitC

PWMA
AIN2

AIN1

STBY
BIN1

BIN2

PWMB
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
TB6612

Driver TB6612FNG

6–12 V

Motorček s prevodovkou

−

−

−
100 µF
C | NO | NC

horný koncový spínač

C | NO | NC

dolný koncový spínač

PIN_MOTOR_IN1, IN2, REZERVA (PWM)

BAT+ (návrh 04)

GND batérie

PIN_KONCAK_HORE, PIN_KONCAK_DOLE

STBY na 3,3 V = driver zapnutý

100 µF pri VM

100 nF na svorkách motora

NC ostáva voľný
