matejsedik/maturitny_projekt-strelba-terce/02_Analyza/use-case.docx

# USE CASE TEMPLATE

Identifikátor:

UC - 05

Názov:

Signalizovanie zásahu

Popis:

Trénerovi sa zobrazí úspešný/neúspešný zásah v aplikácii

Aktéri:

Strelec, Tréner

Vstupné podmienky:

Senzory zásahu

Výstupné podmienky:

Tréner bude mať výsledky streľby.

Spúšťač (Trigger):

Strelec vystrelí na terč.

Hlavný scenár:

1. Strelec vystrelil na terč.
2. Strelec netrafí, zobrazí sa to v aplikácii.
3. Strelec trafí, zobrazí sa to v aplikácii.
4. Strelec trafí všetky terče a cez aplikáciu ich môže tréner znovu postaviť.
5. Po každom postavení sa údaje zapíšu do histórie.

Alternatívne scenáre:
