matejsedik/maturitny_projekt-strelba-terce/07_Prilohy_a_odkazy/konstrukcia_nakres.pdf

# Terčová konštrukcia: nákres

Rám, terčové rady (ľah a stoj), krycí plát s navijakom, krabička s elektronikou. Rozmery v mm.

## NÁVRH KONŠTRUKCIE

### Strana 1/2: technický pohľad spredu a zboku

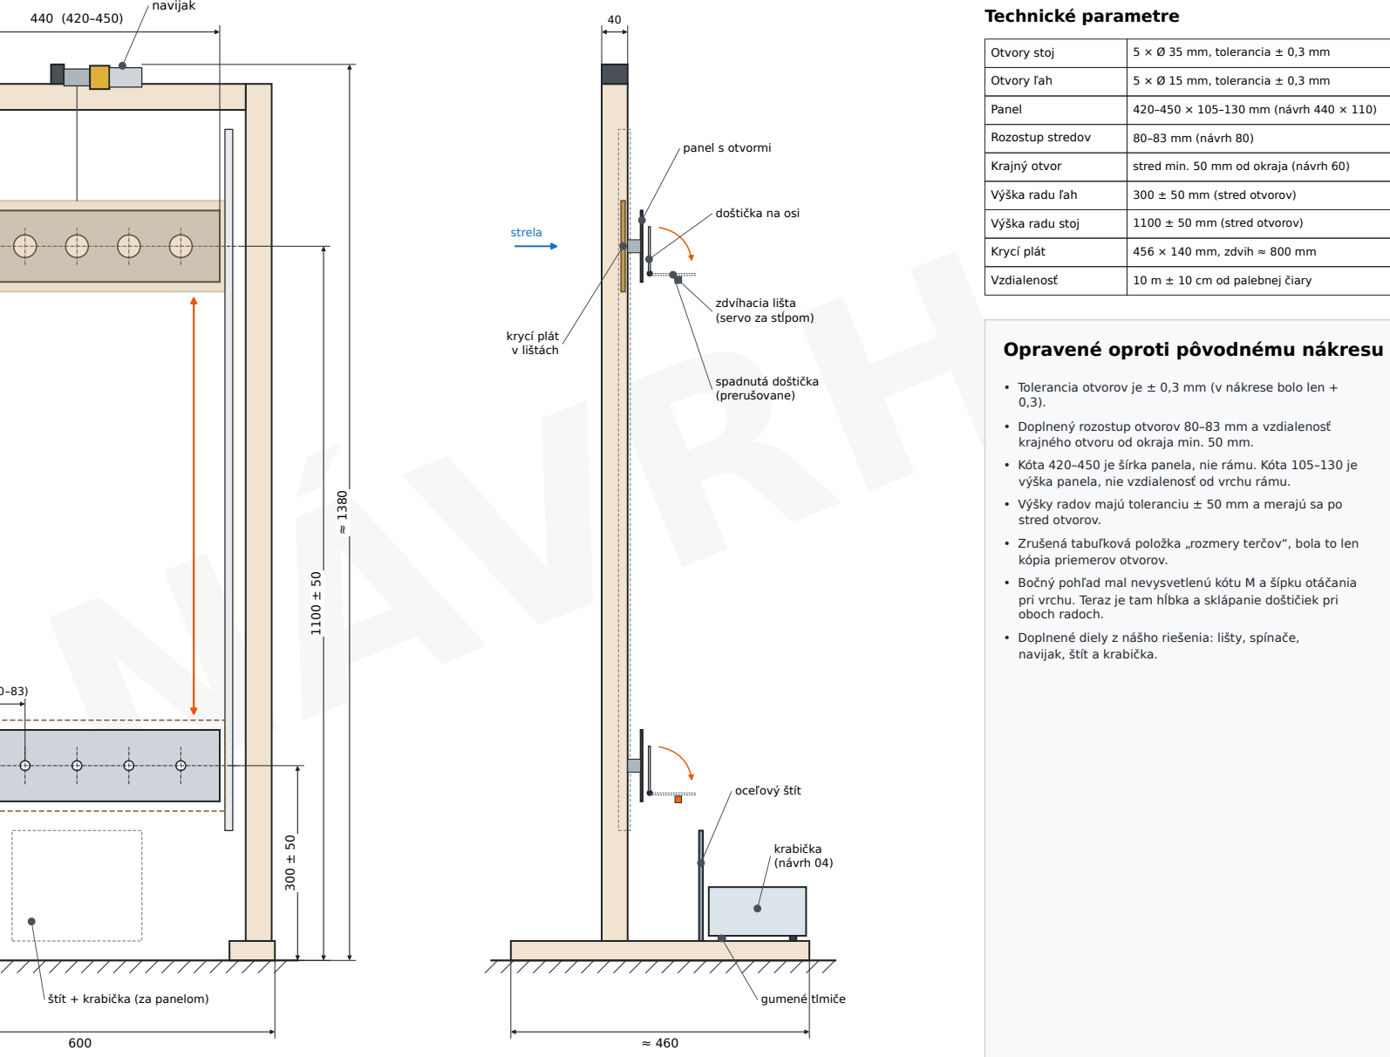
[picture p19: figure]
NÁVRH; Opravené oproti pôvodnému nákresu; krajného otvoru od okraja min. 50 mm.; stred otvorov.; kópia priemerov otvorov.; oboch radoch.; navijak, štít a krabička.; strela; Technické parametre; Rozostup stredov; 80–83 mm (návrh 80); Krycí plát; 456 × 140 mm, zdvih ≈ 800 mm; panel s otvormi; doštička na osi; zdvíhacia lišta (servo za stĺpom); spadnutá doštička (prerušovane); krycí plát v lištách; oceľový štít; krabička (návrh 04); gumené tlmiče

- Tolerancia otvorov je ± 0,3 mm (v nákrese bolo len +
- Doplnený rozostup otvorov 80–83 mm a vzdialenosť
- Kóta 420–450 je šírka panela, nie rámu. Kóta 105–130 je výška panela, nie vzdialenosť od vrchu rámu.
- Výšky radov majú toleranciu ± 50 mm a merajú sa po
- Zrušená tabuľková položka „rozmery terčov“, bola to len
- Bočný pohľad mal nevysvetlenú kótu M a šípku otáčania pri vrchu. Teraz je tam hĺbka a sklápanie doštičiek pri
- Doplnené diely z nášho riešenia: lišty, spínače,

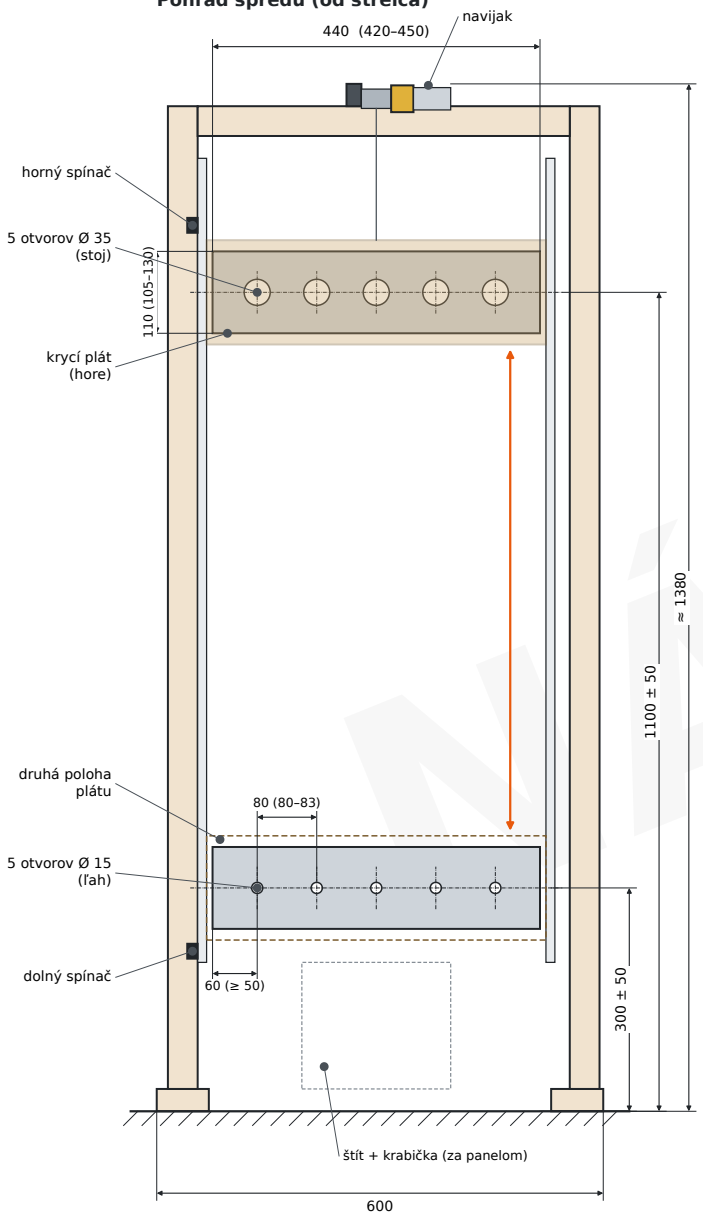
[picture p20: figure]
horný spínač; 5 otvorov Ø 35 (stoj); krycí plát (hore); druhá poloha plátu; 5 otvorov Ø 15 (ľah); dolný spínač; navijak; štít + krabička (za panelom)

Iba návrh na diskusiu, nie výrobný výkres. Presné tvary a rozmery určí 3D návrh (Sára), rozmery terčov sú podľa pravidiel (terce.txt). | konstrukcia_nakres.pdf · návrh z 8. 11. 2026
Otvory stoj | 5 × Ø 35 mm, tolerancia ± 0,3 mm
Otvory ľah | 5 × Ø 15 mm, tolerancia ± 0,3 mm
Panel | 420–450 × 105–130 mm (návrh 440 × 110)
Krajný otvor | stred min. 50 mm od okraja (návrh 60)
Výška radu ľah | 300 ± 50 mm (stred otvorov)
Výška radu stoj | 1100 ± 50 mm (stred otvorov)
Vzdialenosť | 10 m ± 10 cm od palebnej čiary
Pohľad spredu (od strelca) | Pohľad zboku (strelec je vľavo)

# Terčová konštrukcia: nákres

## NÁVRH KONŠTRUKCIE

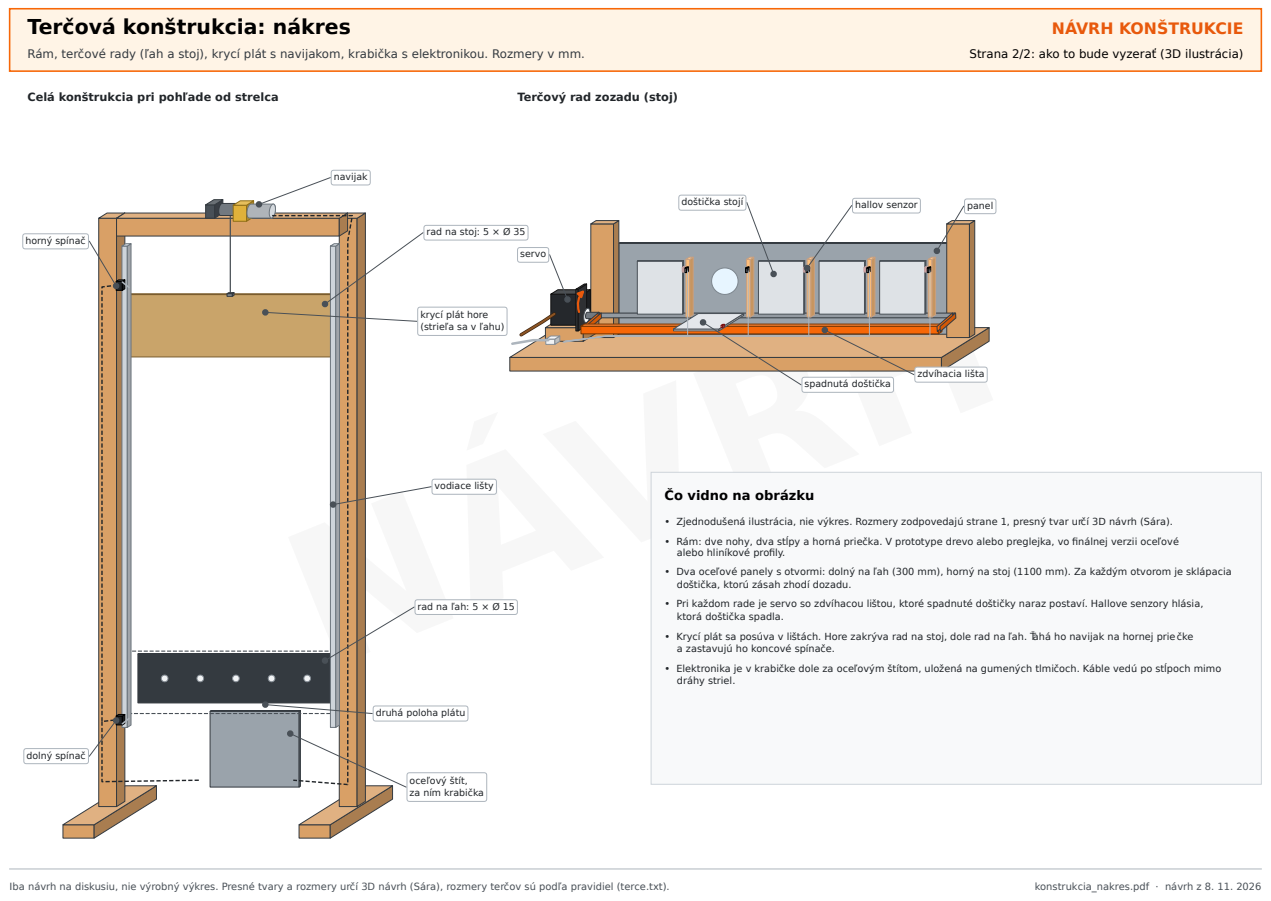
[picture p21: page 2]
NÁVRH; Iba návrh na diskusiu, nie výrobný výkres. Presné tvary a rozmery určí 3D návrh (Sára), rozmery terčov sú podľa pravidiel (terce.txt).; konstrukcia_nakres.pdf · návrh z 8. 11. 2026; Celá konštrukcia pri pohľade od strelca; Terčový rad zozadu (stoj); vodiace lišty; horný spínač; dolný spínač; navijak; servo; zdvíhacia lišta; doštička stojí; spadnutá doštička; hallov senzor; panel

Rám, terčové rady (ľah a stoj), krycí plát s navijakom, krabička s elektronikou. Rozmery v mm.

Strana 2/2: ako to bude vyzerať (3D ilustrácia)

rad na stoj: 5 × Ø 35

krycí plát hore
(strieľa sa v ľahu)

Čo vidno na obrázku

• Zjednodušená ilustrácia, nie výkres. Rozmery zodpovedajú strane 1, presný tvar určí 3D návrh (Sára).
• Rám: dve nohy, dva stĺpy a horná priečka. V prototype drevo alebo preglejka, vo finálnej verzii oceľové
alebo hliníkové profily.
• Dva oceľové panely s otvormi: dolný na ľah (300 mm), horný na stoj (1100 mm). Za každým otvorom je sklápacia
doštička, ktorú zásah zhodí dozadu.
• Pri každom rade je servo so zdvíhacou lištou, ktoré spadnuté doštičky naraz postaví. Hallove senzory hlásia,
ktorá doštička spadla.
• Krycí plát sa posúva v lištách. Hore zakrýva rad na stoj, dole rad na ľah. Ťahá ho navijak na hornej priečke
a zastavujú ho koncové spínače.
• Elektronika je v krabičke dole za oceľovým štítom, uložená na gumených tlmičoch. Káble vedú po stĺpoch mimo
dráhy striel.

rad na ľah: 5 × Ø 15

druhá poloha plátu

oceľový štít,
za ním krabička
