matejsedik/maturitny_projekt-strelba-terce/(commit log)

2026-11-06 Pridane funkcionalne poziadavky a prvotny Use case template
    [funkcionalne-poziadavky.xlsx]
2026-11-08 Pridane súbory na písanie kódov a firmwéru, pridanie kostry tabulky na zapojenie pinov
    [tabulka_pinov.xlsx]
2026-11-09 Zapracované postrehy a usmernenia od p. Hollého
    [tabulka_pinov.xlsx]
